TheHotSummery/sky-music-ljc-opensource/hardware/README.txt

Place exported Gerber / drill / pick-place here.
Also publish the JLCPCB / LCEDA project link in README.
