TheHotSummery/sky-music-ljc-opensource/assets/factory/README.txt

Factory assets source (also embedded in firmware/esp32s3/flash/assets.bin).

piano/1.wav .. 15.wav  - Sky K1..K15, C4..C6 white keys, 22050/16/mono ~2.5s
ui/bg_sky.raw           - theme sky
ui/bg_night.raw         - theme night
puzi/*.txt              - demo scores (ASCII filenames only)

See root NOTICE for sample attribution.
See root README.md for flash instructions.
开源仓库：https://github.com/TheHotSummery/sky-music-ljc-opensource
