TheHotSummery/sky-music-ljc-opensource/assets/factory/piano/README.txt

Factory piano 1.wav..15.wav = Sky K1..K15 = C major white keys:
  1-7  = C4 D4 E4 F4 G4 A4 B4
  8-14 = C5 D5 E5 F5 G5 A5 B5
  15   = C6
Source: nbrosowsky tonejs-instruments piano MP3, exact pitch (no shift).
Format: 22050 Hz / 16-bit / mono, trim 2.5s + fade-out.
