TheHotSummery/sky-music-ljc-opensource/firmware/esp32s3/source/assets/staging/piano-white/README.txt

White-key piano MP3s (C4..C6) from https://nbrosowsky.github.io/tonejs-instruments/samples/piano/
Used to build factory/piano/*.wav without pitch-shift.
