TheHotSummery/sky-music-ljc-opensource/firmware/esp32s3/source/assets/staging/salamander/README.txt

Tone.js Salamander Grand (tonejs.github.io/audio/salamander/), 15 notes C3..Fs6.
CC BY 3.0 — Alexander Holm / Salamander Grand Piano V3.
Not yet wired into factory: audio_bank loads PCM WAV @22050 only (1.wav..15.wav).
Convert/truncate before copying to assets/factory/piano/.
