TheHotSummery/sky-music-ljc-opensource/firmware/esp32s3/source/assets/factory/ui/README.txt

RGB565 LE raw 284x240 (136320 bytes each).
bg_sky.raw   <- Camera_light.jpg (theme sky)
bg_night.raw <- Camera_black.jpg (theme night)
