TheHotSummery/sky-music-ljc-opensource/enclosure/README.txt

异形外壳文件仅供设计参考！！！
异形外壳文件仅供设计参考！！！
异形外壳文件仅供设计参考！！！
