TheHotSummery/sky-music-ljc-opensource/img/function.png

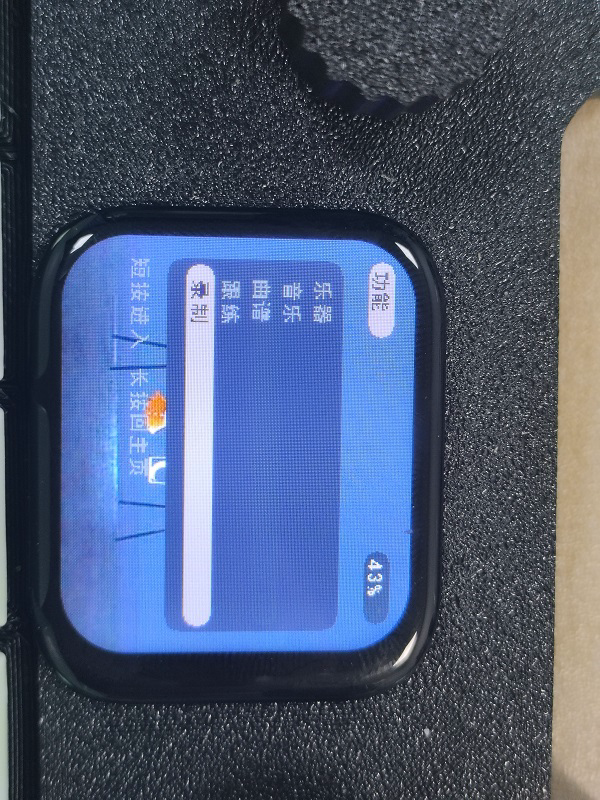
img/function.png
