TheHotSummery/sky-music-ljc-opensource/img/main.png

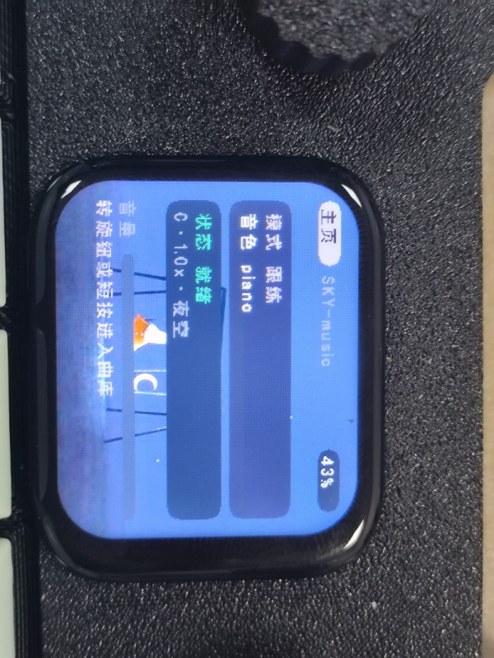
img/main.png
