TheHotSummery/sky-music-ljc-opensource/img/music.png

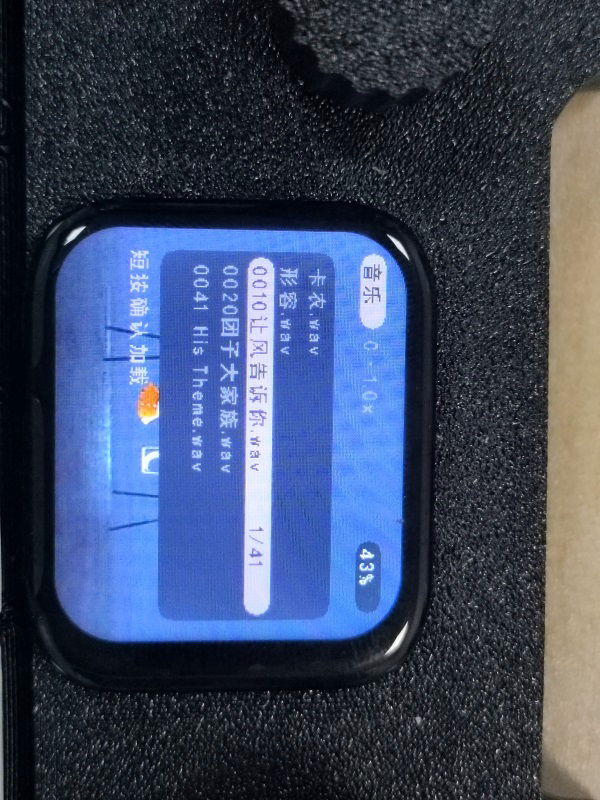
img/music.png
