TheHotSummery/sky-music-ljc-opensource/img/pcb-down.png

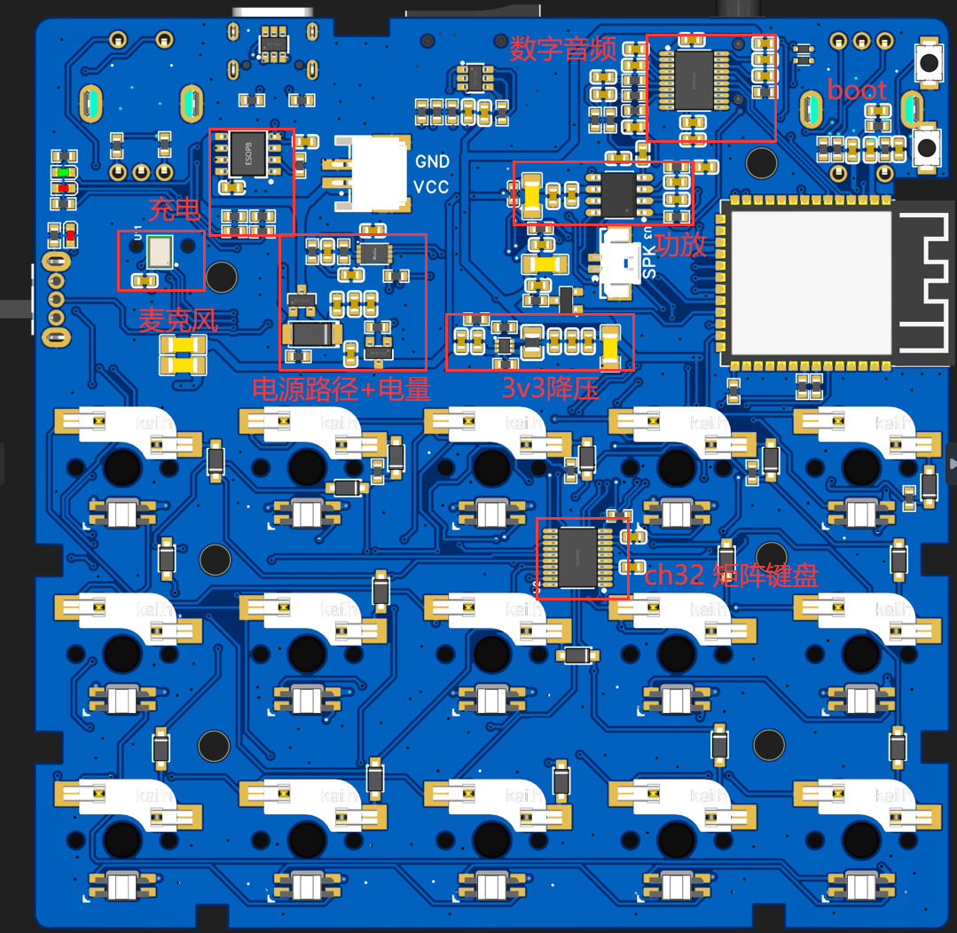
img/pcb-down.png
