TheHotSummery/sky-music-ljc-opensource/img/pcb-up.png

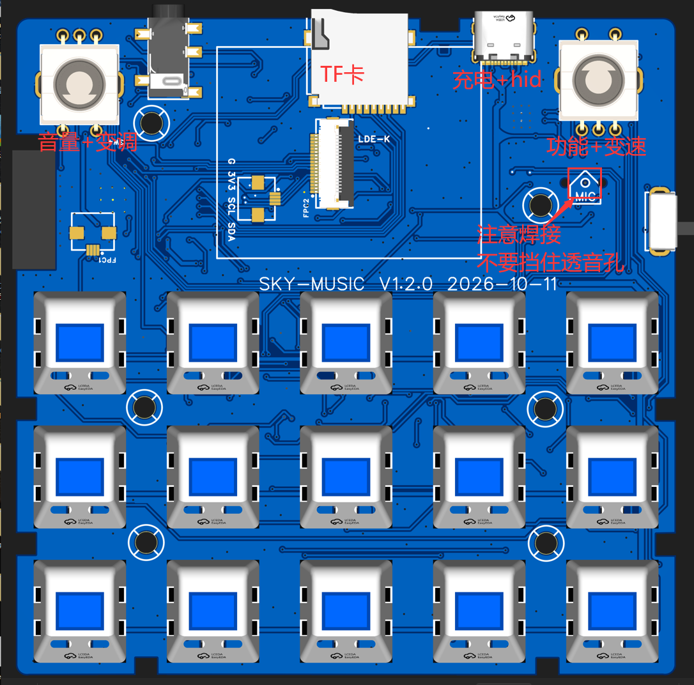
img/pcb-up.png
