TheHotSummery/sky-music-ljc-opensource/img/puzi.png

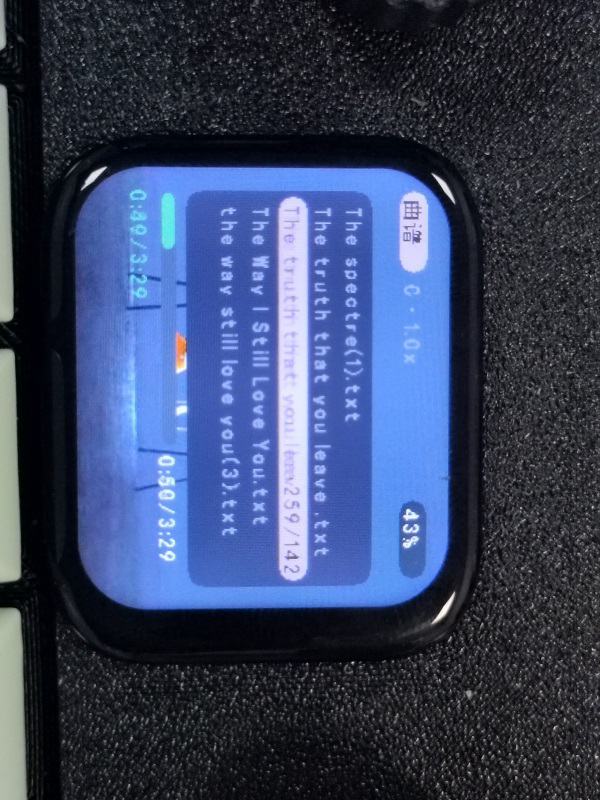
img/puzi.png
