TheHotSummery/sky-music-ljc-opensource/img/right.png

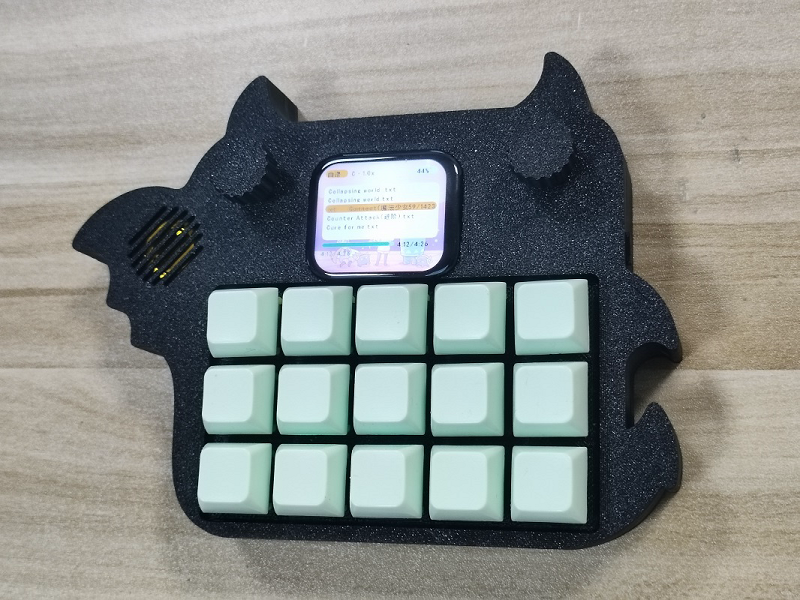
img/right.png
