TheHotSummery/sky-music-ljc-opensource/img/SKY-music：便携式迷你采样器.png

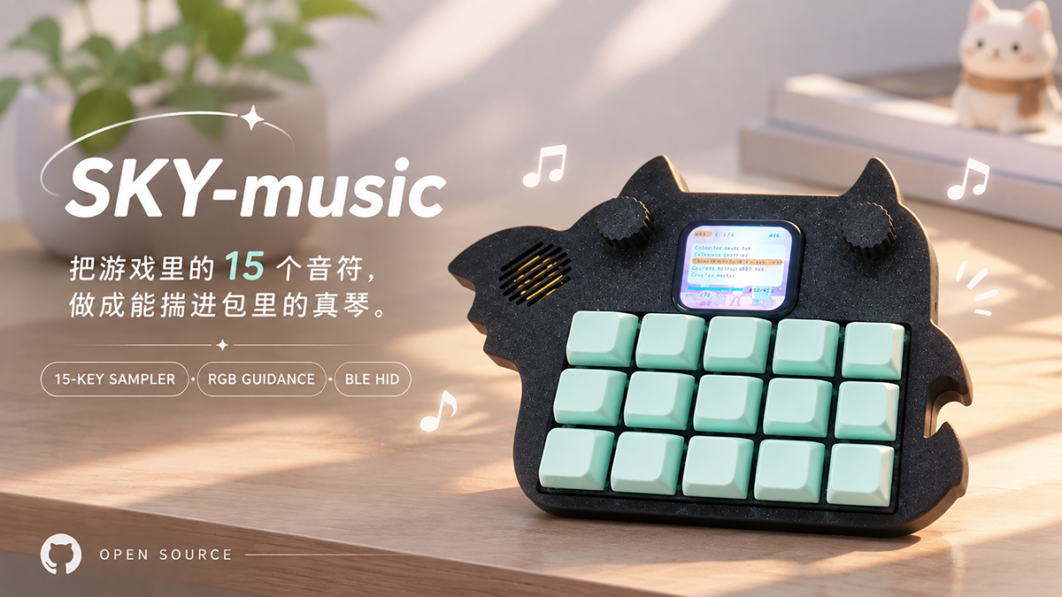
img/SKY-music：便携式迷你采样器.png
