TheHotSummery/sky-music-ljc-opensource/hardware/bom/sky-music.xlsx

No. | Quantity | Comment | Designator | Footprint | Value | Manufacturer Part | Manufacturer | Supplier Part | Supplier
1 | 16 | 100nF | C1,C5,C9,C11,C13,C15,C19,C20,C22,C23,C29,C30,C38,C41,C48,C54 | C0603 | 100nF
2 | 13 | 10uF | C2,C14,C16,C21,C24,C28,C33,C34,C46,C47,C49,C50,C53 | C0603 | 10uF
3 | 4 | 22uF | C3,C4,C10,C31 | C0603 | 22uF
4 | 4 | 1uF | C6,C7,C8,C12 | C0603 | 1uF
5 | 2 | 2.2uF | C17,C18 | C0603 | 2.2uF
6 | 5 | 100uF（此处找一些耐压10V 或者以上的MLCC替代就行，不一定100uF,也可不加，看需求） | C25,C26,C27,C32,C36 | C1206 | 100uF | CL31A107MQHNNNE | SAMSUNG(三星) | C15008 | LCSC
7 | 2 | 2.2nF | C39,C40 | C0603 | 2.2nF
8 | 2 | 12pF | C51,C52 | C0603 | 12pF
9 | 1 | TF PUSH | CARD1 | TF-SMD_TF-PUSH |  | TF PUSH | SHOU HAN(首韩) | C393941 | LCSC
10 | 1 | HC-PH-2AWT | CN2 | CONN-SMD_PH-2AWT |  | HC-PH-2AWT | HCTL(华灿天禄) | C2845442 | LCSC
11 | 16 | 1N4148W | D1,D2,D3,D4,D5,D6,D7,D8,D9,D10,D11,D12,D13,D14,D15,D16 | SOD-123F_L2.7-W1.6-LS3.8-RD |  | 1N4148W | ST(先科) | C81598 | LCSC
12 | 1 | SS34 | D17 | SMA_L4.3-W2.6-LS5.2-RD |  | SS34 | MDD(辰达半导体) | C8678 | LCSC
13 | 2 | SRV05-4-A | D18,D19 | SOT-23-6_L2.9-W1.6-P0.95-LS2.8-BR |  | SRV05-4-A | PROTEK | C3707003 | LCSC
14 | 2 | ESD5Z5.0C | D20,D21 | SOD-523_L1.2-W0.8-LS1.6-BI |  | ESD5Z5.0C | SHIKUES(时科) | C475686 | LCSC
15 | 2 | LAIL-FPC-CX01-4P0.5-W | FPC1,FPC3 | FPC-SMD_LAIL-FPC-CX01-4P0.5-W |  | LAIL-FPC-CX01-4P0.5-W | LAILAN(莱联) | C55173038 | LCSC
16 | 1 | LAIL-FPC-CX01-18P0.5-W | FPC2 | FPC-SMD_LAIL-FPC-CX01-18P0.5-W |  | LAIL-FPC-CX01-18P0.5-W | LAILAN(莱联) | C55173036 | LCSC
17 | 15 | 0910凯华轴座+3528反贴灯 | K1,K2,K3,K4,K5,K6,K7,K8,K9,K10,K11,K12,K13,K14,K15 | 0910凯华轴座+3528反贴灯
18 | 1 | 1.0uH | L2 | L0806 | 1.0uH | PCT201610-1R0-M | JIERR(捷而瑞) |  | LCSC
19 | 2 | UPZ1608E121-3R0TF | L3,L4 | L0603 |  | UPZ1608E121-3R0TF | Sunlord(顺络) | C279682 | LCSC
20 | 1 | LED_0603-G | LED1 | LED_0603
21 | 2 | LED_0603-R | LED2,LED3 | LED_0603
22 | 1 | PJ-327A | PJ1 | AUDIO-IN-SMD_PJ-327A_C22355751 |  | PJ-327A | SOFNG(硕方) | C22355751 | LCSC
23 | 2 | AO3401A_P | Q2,Q3 | AO3401A_SOT-23-3 |  |  |  | C15127
24 | 2 | 5.1K | R1,R2 | R0603 | 5.1K
25 | 1 | 1.6K | R3 | R0603 | 1.6K
26 | 2 | 1K | R4,R5 | R0603 | 1K
27 | 3 | 100K | R6,R20,R26 | R0603 | 100K
28 | 3 | 470 | R7,R15,R16 | R0603 | 470
29 | 1 | 100 | R8 | R0603 | 100
30 | 3 | 4.7K | R9,R29,R30 | R0603 | 4.7K
31 | 21 | 10K | R10,R11,R12,R13,R14,R19,R22,R23,R25,R27,R28,R31,R32,R33,R34,R35,R39,R40,R43,R44,R45 | R0603 | 10K
32 | 2 | 470k | R17,R18 | R0603 | 470k
33 | 3 | 20K | R21,R24,R38 | R0603 | 20K
34 | 1 | 3.3K | R36 | R0603 | 3.3K
35 | 1 | 91K | R37 | R0603 | 91K
36 | 1 | 235k | R41 | R0603 | 235k
37 | 1 | 33 | R42 | R0603 | 33
38 | 6 | M3螺丝 | SCREW1,SCREW2,SCREW3,SCREW4,SCREW5,SCREW6 | M3螺丝
39 | 1 | SK12D07VG5 | SW1 | SW-TH_SK12D07VG5-1 |  | SK12D07VG5 | SHOU HAN(首韩) | C431548 | LCSC
40 | 2 | TS-1088-AR02016 | SW2,SW5 | SW-SMD_L3.9-W3.0-P4.45 |  | TS-1088-AR02016 | XUNPU(讯普) | C720477 | LCSC
41 | 2 | EC11E15244B2 | SW3,SW4 | SW-TH_EC11XXXXXXXX |  | EC11E15244B2 | ALPSALPINE(阿尔卑斯阿尔派) | C470754 | LCSC
42 | 1 | 2.4GHz | U1 | WIRELM-SMD_ESP32-S3-WROOM-1 | 2.4GHz | ESP32-S3-WROOM-1-N8R8 | ESPRESSIF(乐鑫) | C2913201 | LCSC
43 | 1 | CH32V003F4P6 | U2 | TSSOP-20_L6.5-W4.4-P0.65-LS6.4-BL |  | CH32V003F4P6 |  | C9900042572 | LCSC
44 | 1 | ZX-MX1.25-2PWT | U3 | CONN-SMD_2P-P1.25_MEGASTAR_ZX-MX1.25-2PWT |  | ZX-MX1.25-2PWT | Megastar(兆星) | C7430468 | LCSC
45 | 1 | CW2015CHBD | U4 | TDFN-8_L3.0-W2.0-P0.50-BL-EP |  | CW2015CHBD | Cellwise(赛微) | C881838 | LCSC
46 | 1 | TP4056 | U5 | ESOP-8_L4.9-W3.9-P1.27-LS6.0-BL-EP |  | TP4056 | UMW(友台半导体) | C725790 | LCSC
47 | 1 | ao3400a | U6 | SOT-23-3_L2.9-W1.3-P1.90-LS2.6-BR |  | ao3400a |  | C9900089444 | LCSC
48 | 1 | PCM5102 | U7 | TSSOP-20_L6.5-W4.4-P0.65-LS6.4-BL |  | PCM5102 |  | C9900003814 | LCSC
49 | 1 | HT6872 | U8 | SOP-8_L4.9-W3.9-P1.27-LS6.0-BL |  | HT6872 | 嘉兴禾润 | C93112 | LCSC
50 | 1 | MP1605GTF | U9 | SOT-563_L1.6-W1.2-P0.50-LS1.6-BL |  | MP1605GTF |  | C2844198 | LCSC
51 | 1 | ICS-43434（用 ZTS6672 平替） | U11 | MIC-SMD_6P-L3.5-W2.7-P0.90-BL |  | ICS-43434 | TDK InvenSense(应美盛) | C5656610 | LCSC
52 | 1 | typec | USB1 | USB-C-SMD_KH-TYPE-C-16P |  | typec |  | C9900016956 | LCSC
