TheHotSummery/sky-music-ljc-opensource/enclosure/下盖.STEP

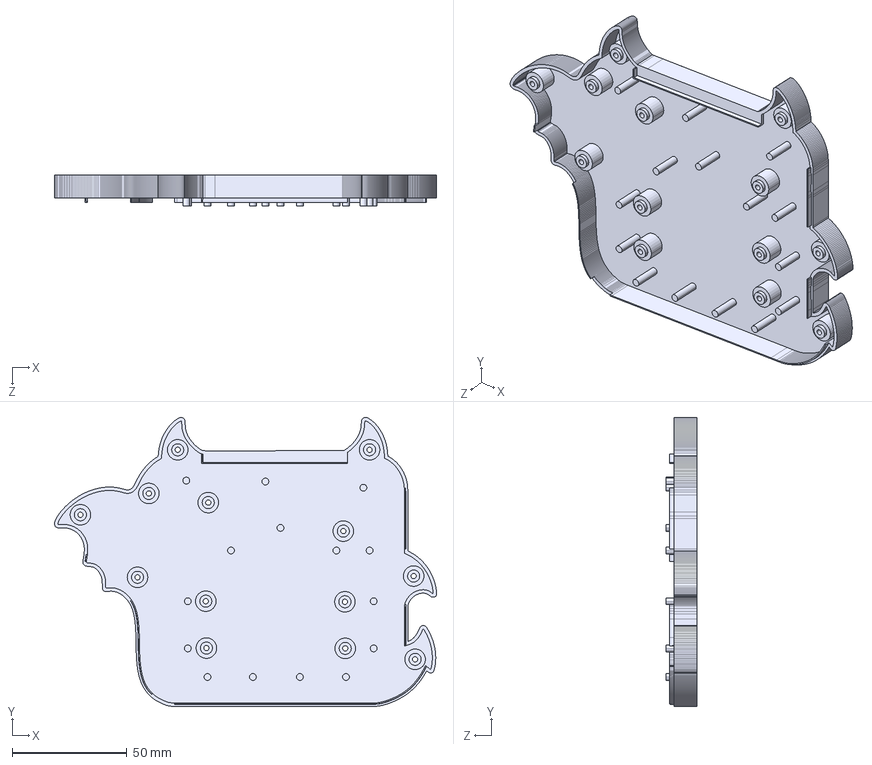
[picture p22: CAD file, 2026-10-31]
enclosure/下盖.STEP
166.7 x 126.1 x 13.5 mm
