TheHotSummery/sky-music-ljc-opensource/enclosure/上盖基准.dxf

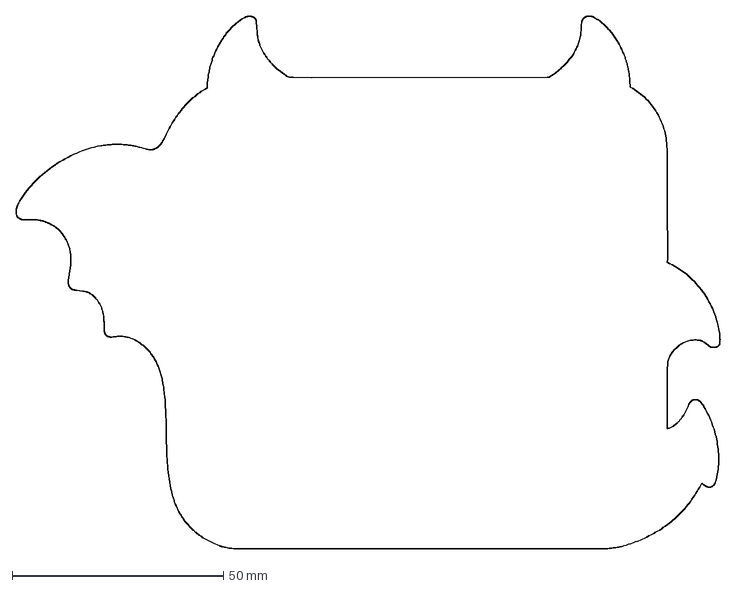
[picture p23: CAD file, 2026-10-31]
enclosure/上盖基准.dxf
166.7 x 126.1 mm
