TheHotSummery/sky-music-ljc-opensource/enclosure/开关拨动器.STEP

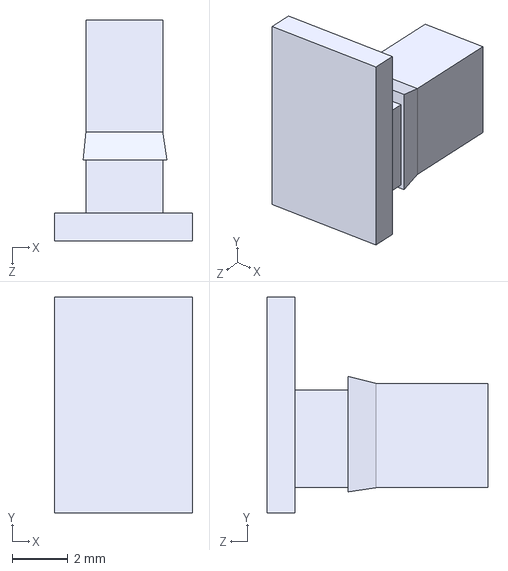
[picture p24: CAD file, 2026-10-31]
enclosure/开关拨动器.STEP
4.95 x 7.73 x 7.90 mm
