TheHotSummery/sky-music-ljc-opensource/enclosure/旋钮.STEP

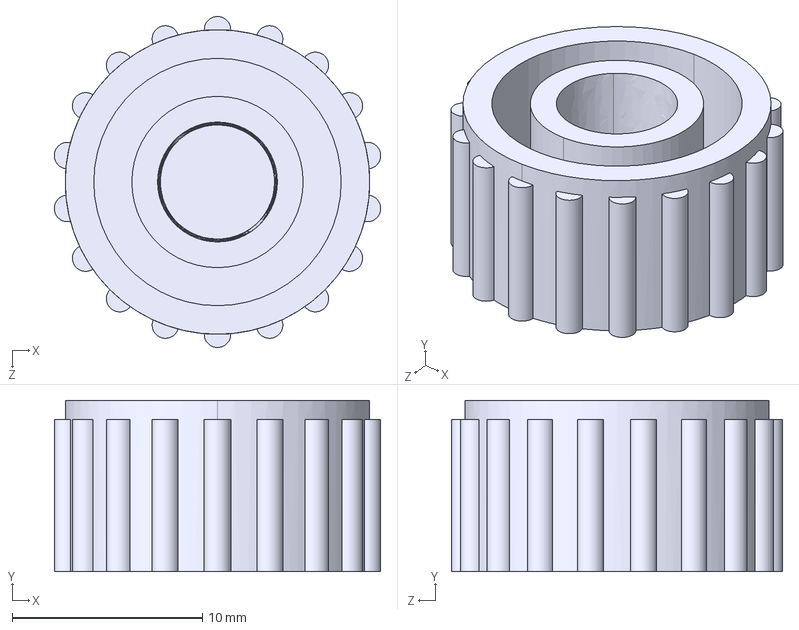
[picture p25: CAD file, 2026-10-31]
enclosure/旋钮.STEP
17.2 x 9.00 x 17.4 mm
