TheHotSummery/sky-music-ljc-opensource/enclosure/上盖.STEP

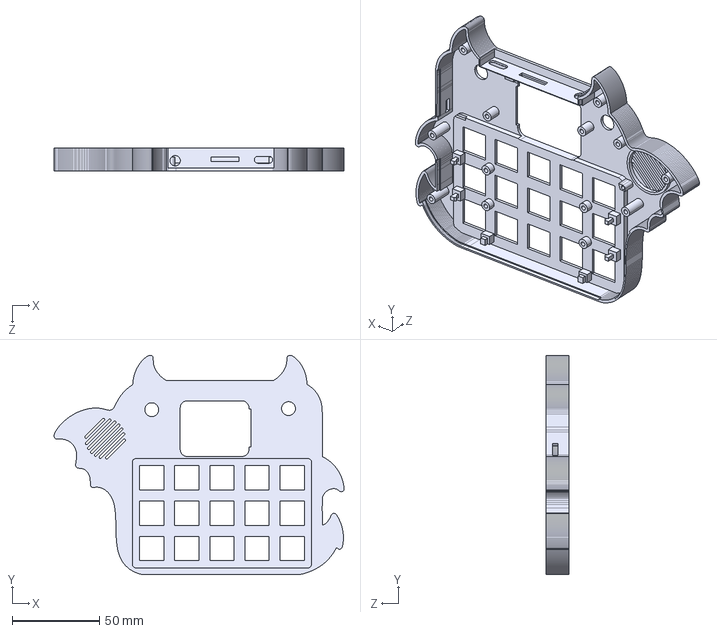
[picture p26: CAD file, 2026-10-31]
enclosure/上盖.STEP
166.7 x 126.1 x 13.0 mm
