TheHotSummery/sky-music-ljc-opensource/(list of files, cad)

Other CAD files:
enclosure/旋钮版本1.SLDPRT
enclosure/3D_3x3+rgb_2026-10-14.step
enclosure/开关拨动器.SLDPRT
