TheHotSummery/sky-music-ljc-opensource/hardware/SKYMUSIC 原理图.pdf

# typec

# 电池充电

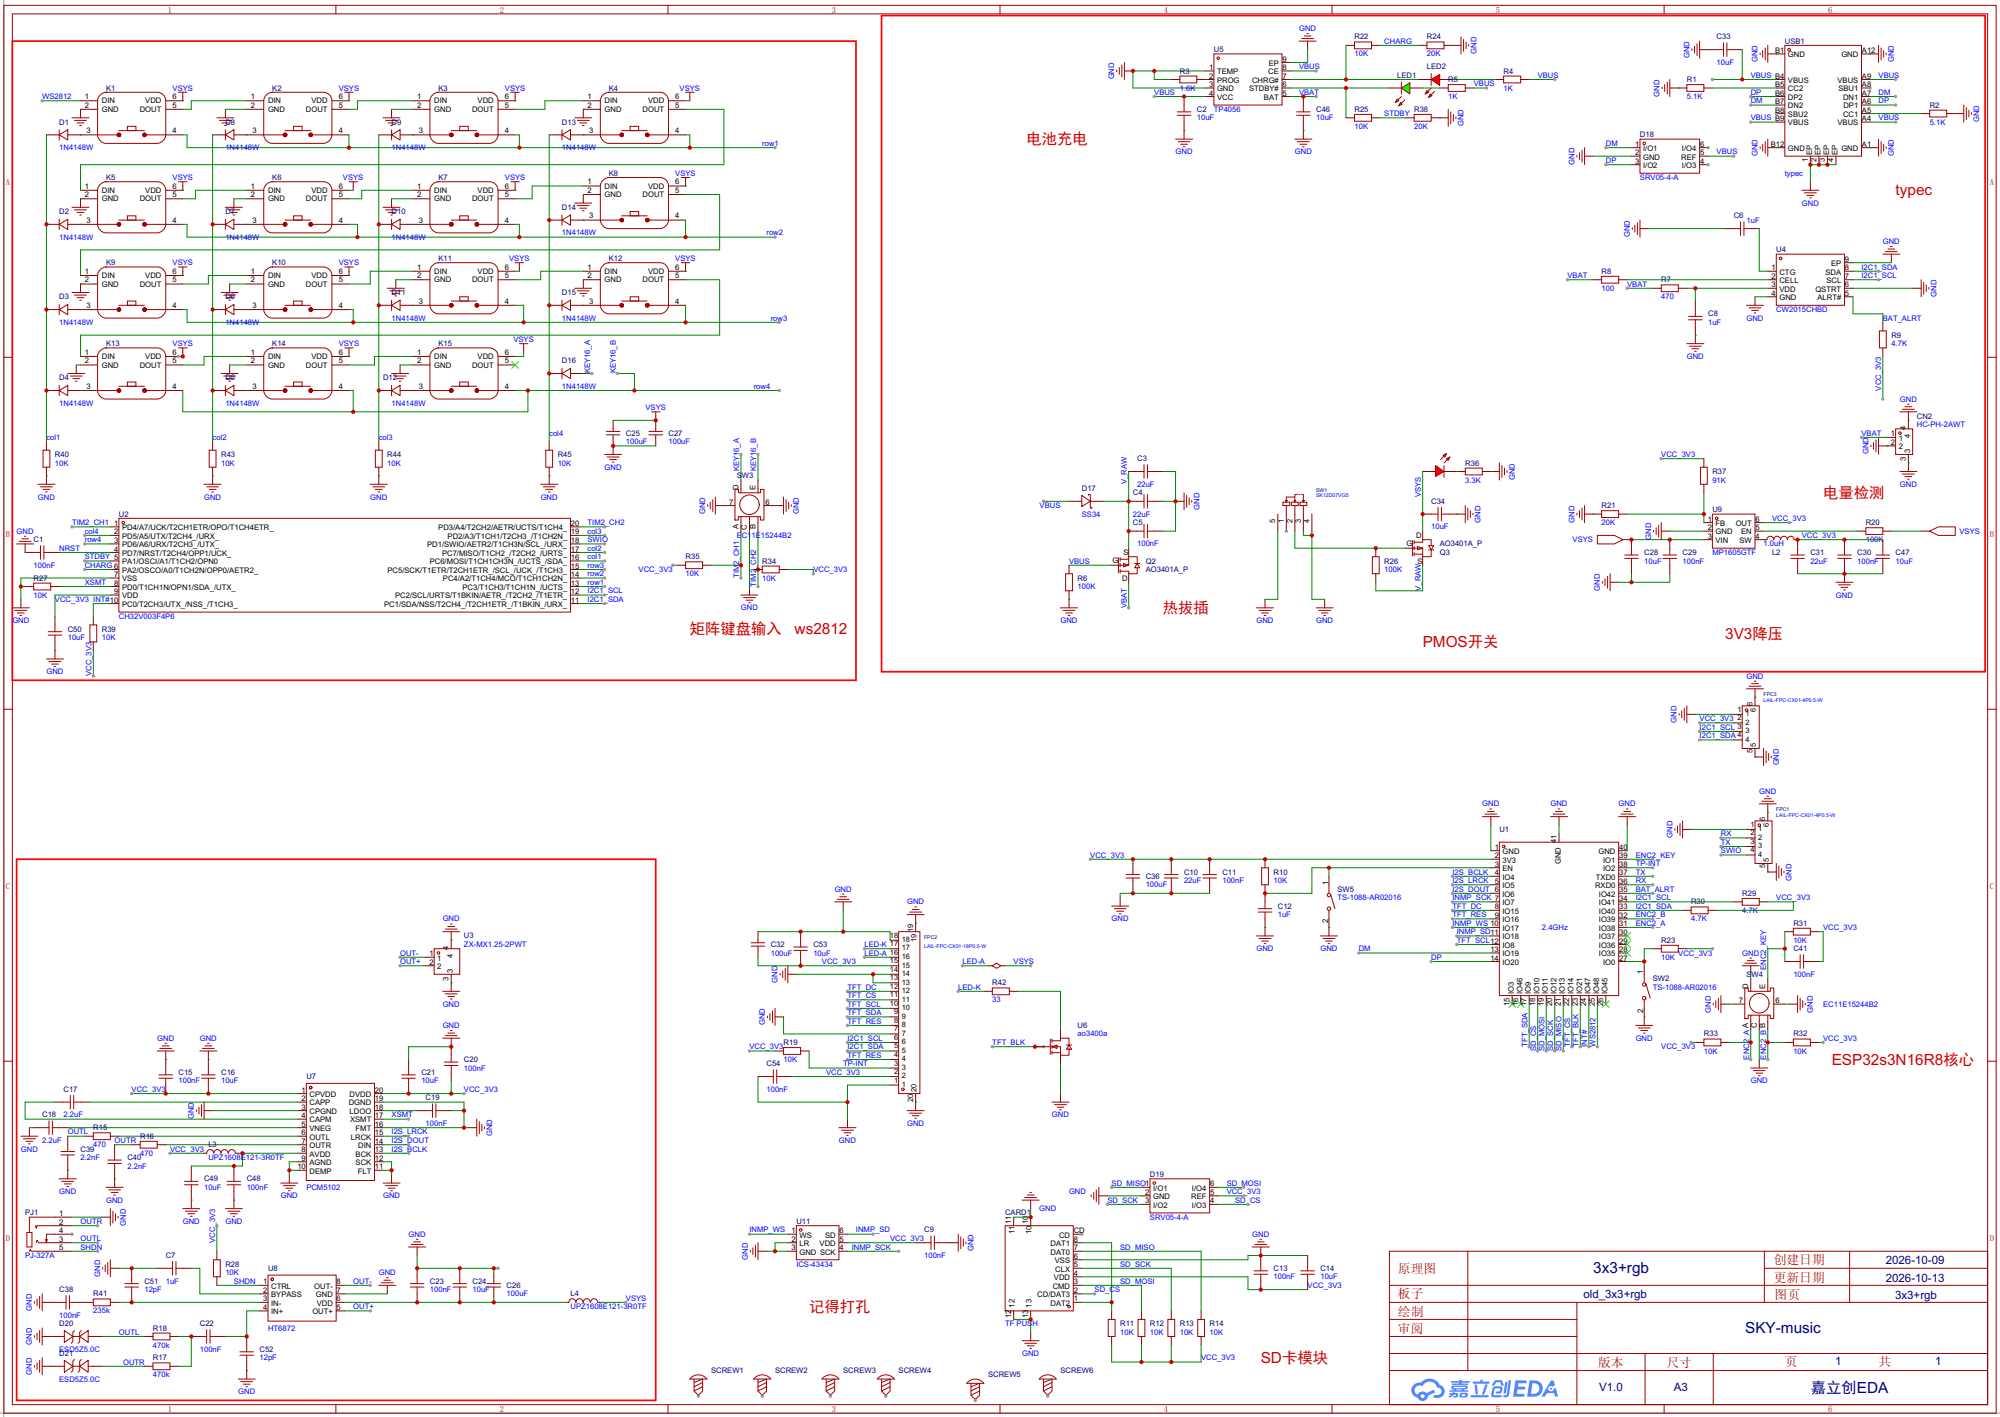
[picture p27: page 1]
